Jawad-Nahin/Logic-Gates-Based-Line-Following-Robot/Schematic_Logic-Gate-Based-LFR_2025-12-27.pdf

# IR Sensor Module Connectors Motor Outputs

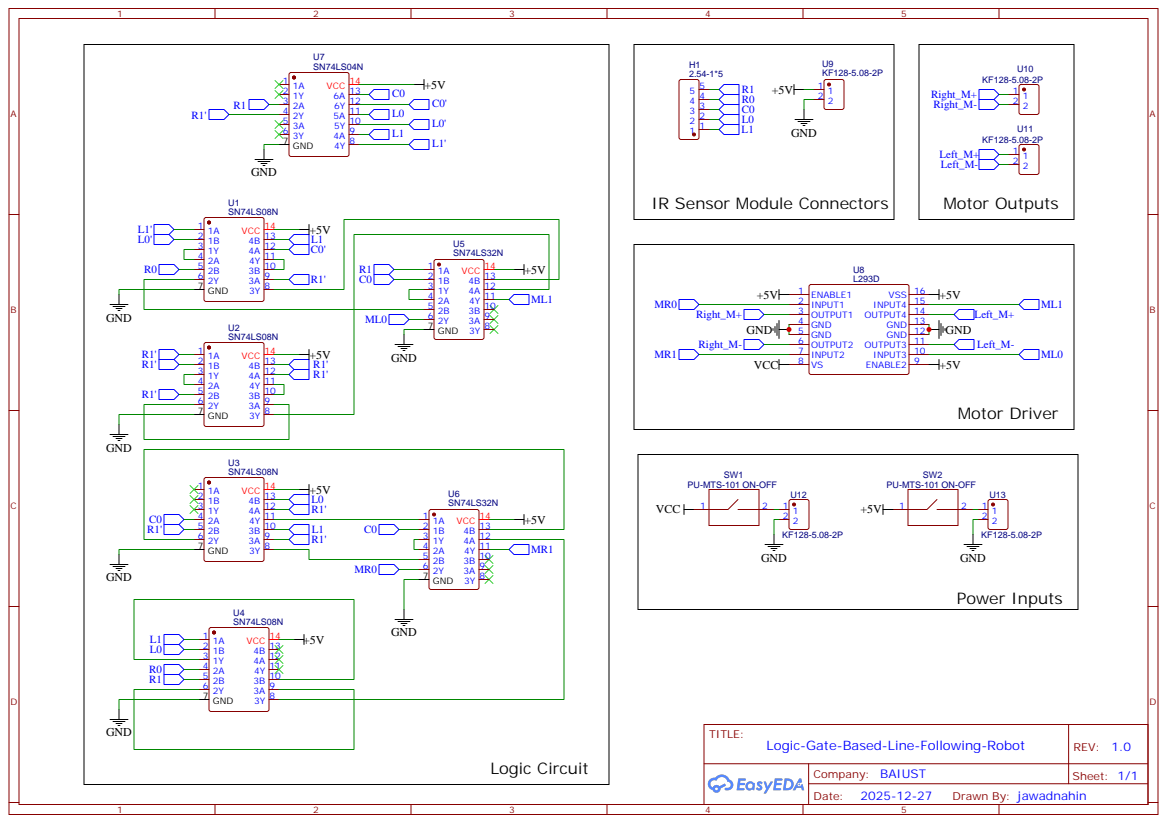
[picture p18: page 1]

PU-MTS-101 ON-OFF
