Jawad-Nahin/Logic-Gates-Based-Line-Following-Robot/(list of files, drawings)

Other design files:
Logic_CKT.circ
