Jawad-Nahin/Logic-Gates-Based-Line-Following-Robot/(commit log)

2025-12-26 Truth Table
    5bit Inputs from the five IR Sensor Module to 4bit Outputs to controll motors through motor driver.
2025-12-26 Flowchart of working process.
2025-12-26 Logic Circuit Diagram
    Diagram of the logic circuit.
2025-12-26 Main Circuit Diagram
2025-12-26 Logic_Circuit_Simulation
    In the software "Logic Friday" we simulated the logic circuit.
    [Logic_CKT.circ]
2025-12-27 Full Circuit Schematic in EasyEDA
2025-12-27 Full Circuit Diagram
2025-12-27 Gerber file of the main PCB
2026-08-31 Add boolean equations section to README
    Added boolean equations for motor outputs with simplified expressions.
2026-08-31 Add section for circuit diagram in README
